yanataka60/ZK80mini_SD/KiCad/KUT_Connector_pretty/README.md

# KUT_Connector.pretty
KUT KiCad Connector footprint library
