yanataka60/ZK80mini_SD/JPEG/ZK80mini_sd_2.JPG

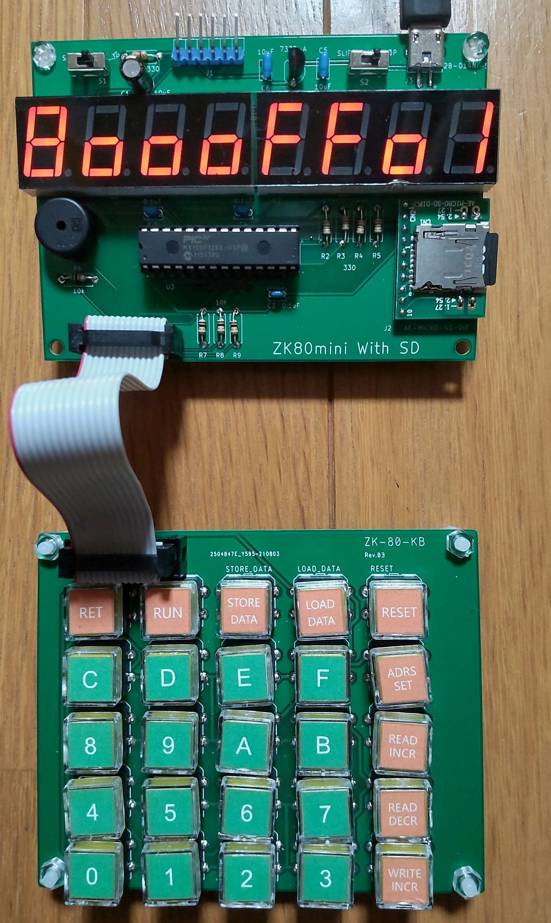
JPEG/ZK80mini_sd_2.JPG
