yanataka60/ZK80mini_SD/KiCad/zk80mini_SD.pdf

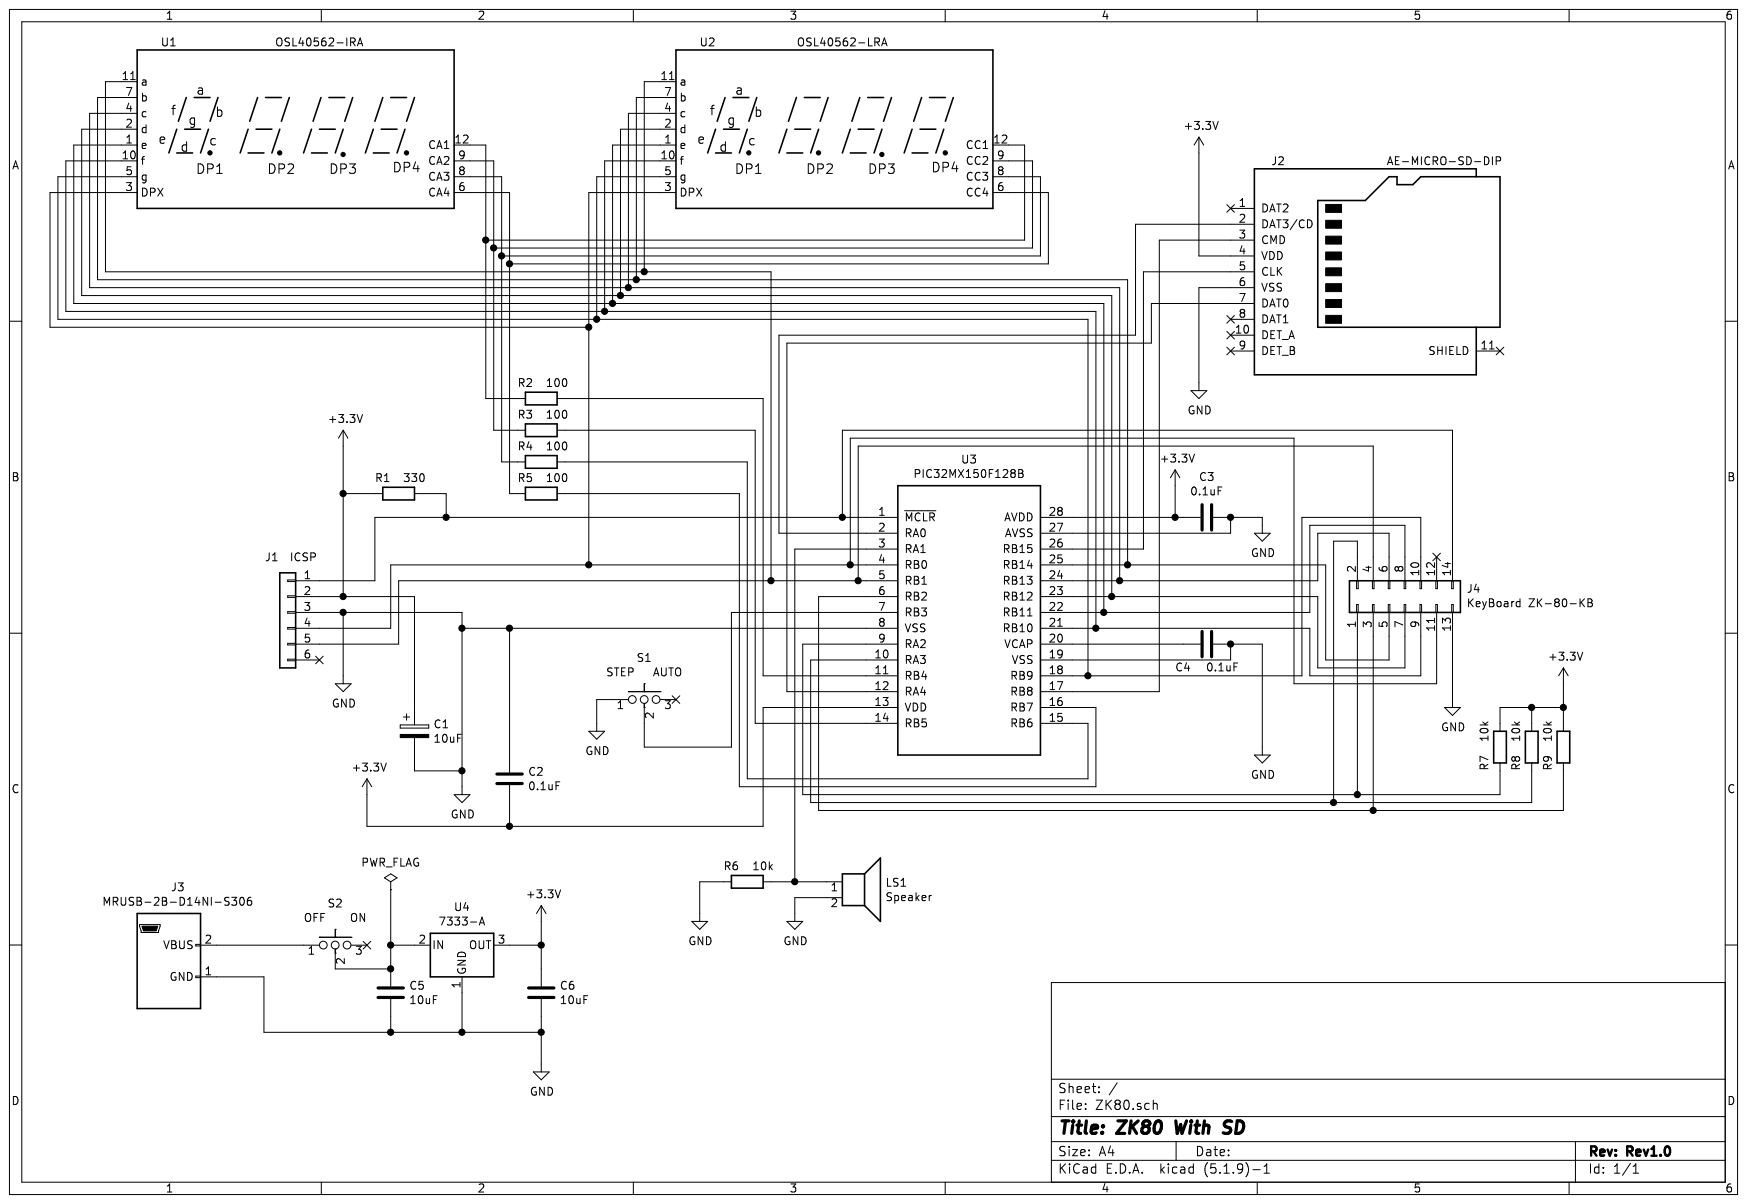
[picture p4: page 1]
