yanataka60/ZK80mini_SD/(list of files, drawings)

Other design files:
KiCad/ZK80.dsn
