yanataka60/ZK80mini_SD/KiCad/ZK80.kicad_pcb

## KiCad design KiCad/ZK80.kicad_pcb (2022-05-04)

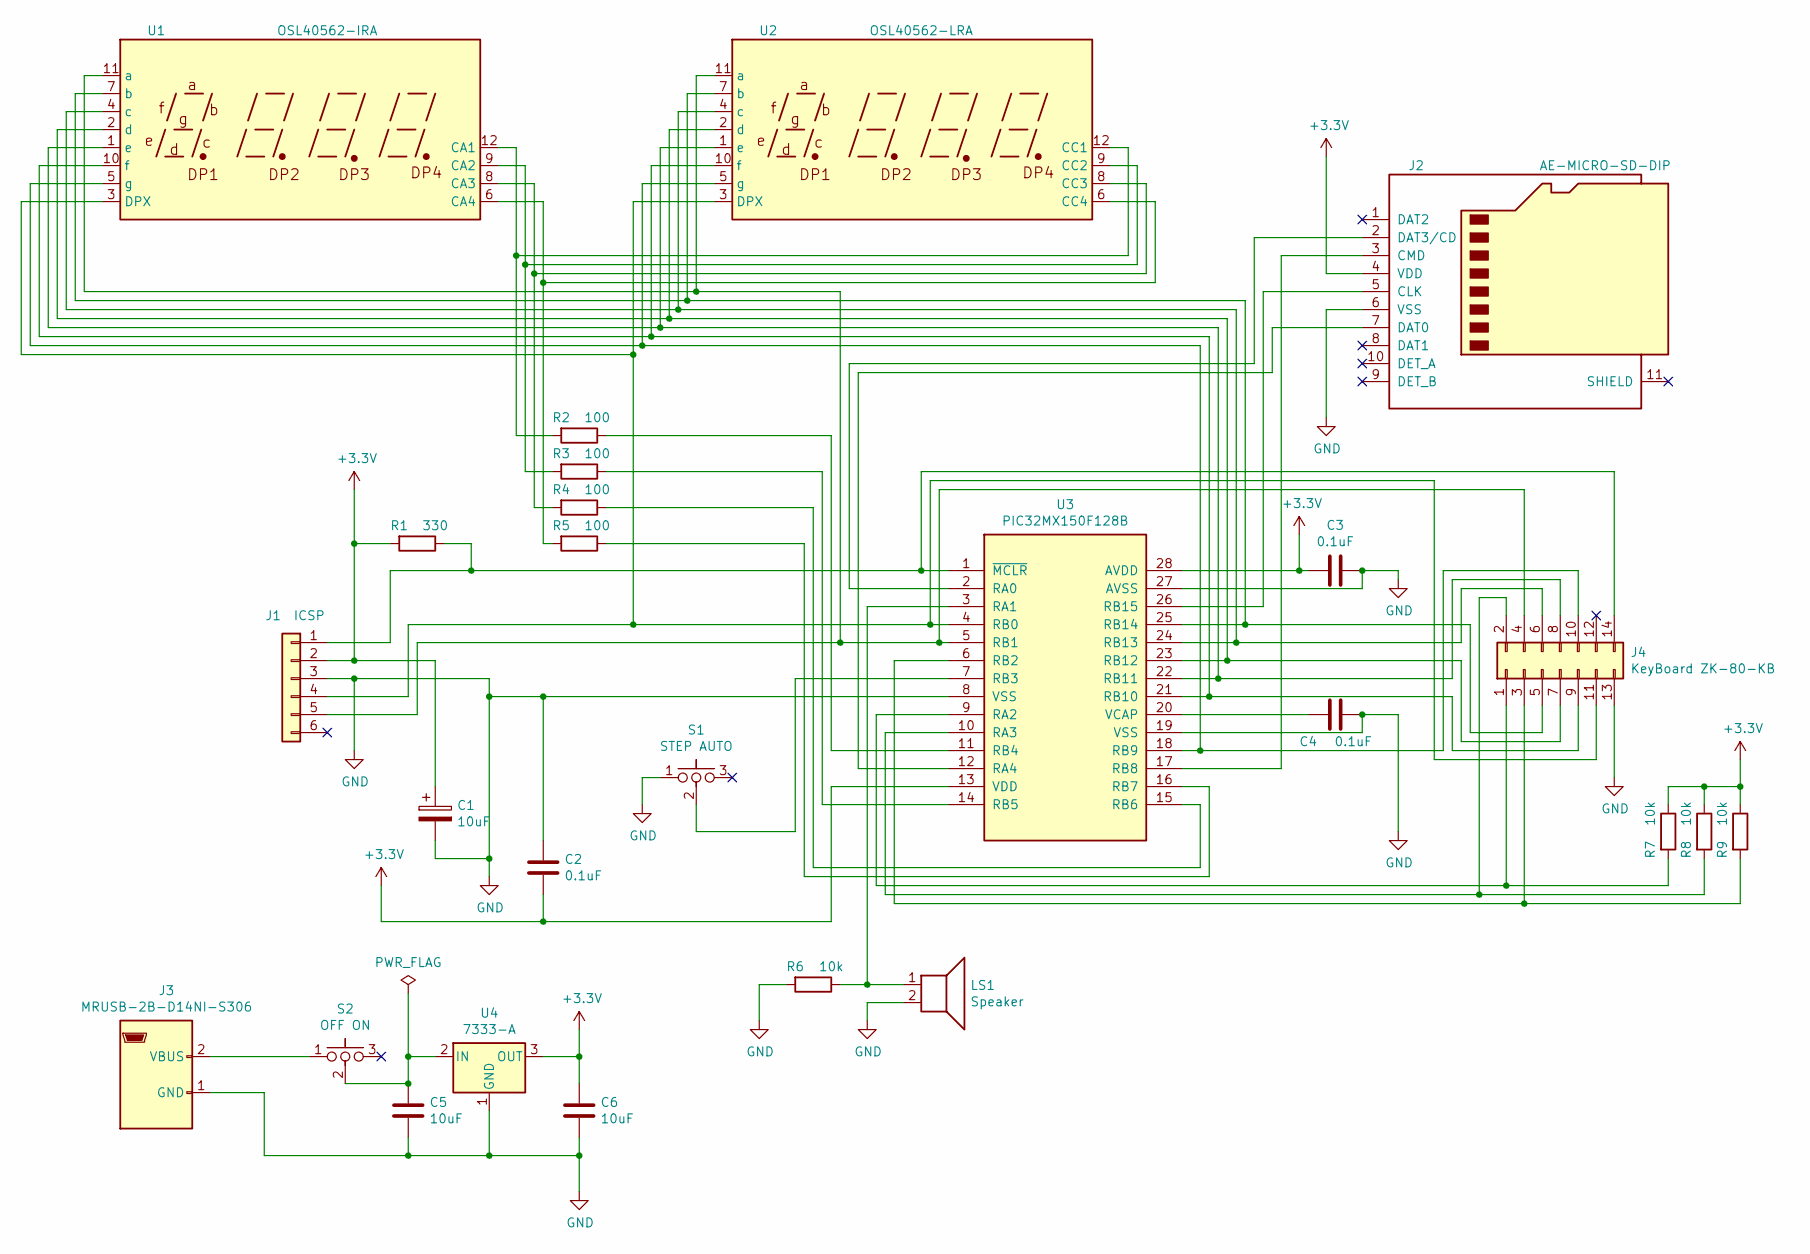
[picture p5: schematic ZK80.sch, ZK80 With SD]

Parts:
C1: 10uF; CP_Radial_D5.0mm_P2.50mm
C2, C3, C4: 0.1uF; C_Rect_L4.0mm_W2.5mm_P2.50mm
C5, C6: 10uF; C_Rect_L4.0mm_W2.5mm_P2.50mm
J1: ICSP; PinHeader_1x06_P2.54mm_Horizontal
J2: AE-MICRO-SD-DIP
J3: MRUSB-2B-D14NI-S306
J4: KeyBoard ZK-80-KB; PinHeader_2x07_P2.54mm_Vertical
LS1: Speaker; TO-5-2
R1: 330; R_Axial_DIN0207_L6.3mm_D2.5mm_P7.62mm_Horizontal
R2, R3, R4, R5: 100; R_Axial_DIN0207_L6.3mm_D2.5mm_P7.62mm_Horizontal
R6, R7, R8, R9: 10k; R_Axial_DIN0207_L6.3mm_D2.5mm_P7.62mm_Horizontal
S1: STEP AUTO; PinHeader_1x03_P2.54mm_Vertical
S2: OFF ON; PinHeader_1x03_P2.54mm_Vertical
U1: OSL40562-IRA; CA56-12EWA
U2: OSL40562-LRA; CA56-12EWA
U3: PIC32MX150F128B; DIP-28_W7.62mm_LongPads
U4: 7333-A; TO-92_Inline_Wide

Connections:
+3V3: C1.1, C2.2, C3.1, C6.1, J1.2, J2.4 (VDD), R1.2, R7.1, R8.1, R9.1, U3.13 (VDD), U3.28 (AVDD), U4.3 (OUT)
GND: C1.2, C2.1, C3.2, C4.2, C5.2, C6.2, J1.3, J2.6 (VSS), J3.1 (GND), J4.13, LS1.2, R6.2, S1.1, U3.8 (VSS), U3.19 (VSS), U3.27 (AVSS), U4.1 (GND)
unnamed: C4.1, U3.20 (VCAP)
unnamed: C5.1, S2.2, U4.2 (IN)
unnamed: J1.1, J4.14, R1.1, U3.1 (~MCLR)
unnamed: J1.4, J4.11, U1.3 (DPX), U2.3 (DPX), U3.4 (RB0)
unnamed: J1.5, J4.4, U1.11 (a), U2.11 (a), U3.5 (RB1)
unnamed: J2.2 (DAT3/CD), U3.2 (RA0)
unnamed: J2.3 (CMD), U3.17 (RB8)
unnamed: J2.5 (CLK), U3.26 (RB15)
unnamed: J2.7 (DAT0), U3.12 (RA4)
unnamed: J3.2 (VBUS), S2.1
unnamed: J4.1, R7.2, U3.9 (RA2)
unnamed: J4.2, R8.2, U3.10 (RA3)
unnamed: J4.3, R9.2, U3.6 (RB2)
unnamed: J4.5, U1.7 (b), U2.7 (b), U3.25 (RB14)
unnamed: J4.6, U1.4 (c), U2.4 (c), U3.24 (RB13)
unnamed: J4.7, U1.2 (d), U2.2 (d), U3.23 (RB12)
unnamed: J4.8, U1.1 (e), U2.1 (e), U3.22 (RB11)
unnamed: J4.9, U1.10 (f), U2.10 (f), U3.21 (RB10)
unnamed: J4.10, U1.5 (g), U2.5 (g), U3.18 (RB9)
unnamed: LS1.1, R6.1, U3.3 (RA1)
unnamed: R2.1, U3.11 (RB4)
unnamed: R2.2, U1.12 (CA1), U2.12 (CC1)
unnamed: R3.1, U3.14 (RB5)
unnamed: R3.2, U1.9 (CA2), U2.9 (CC2)
unnamed: R4.1, U3.15 (RB6)
unnamed: R4.2, U1.8 (CA3), U2.8 (CC3)
unnamed: R5.1, U3.16 (RB7)
unnamed: R5.2, U1.6 (CA4), U2.6 (CC4)
unnamed: S1.2, U3.7 (RB3)

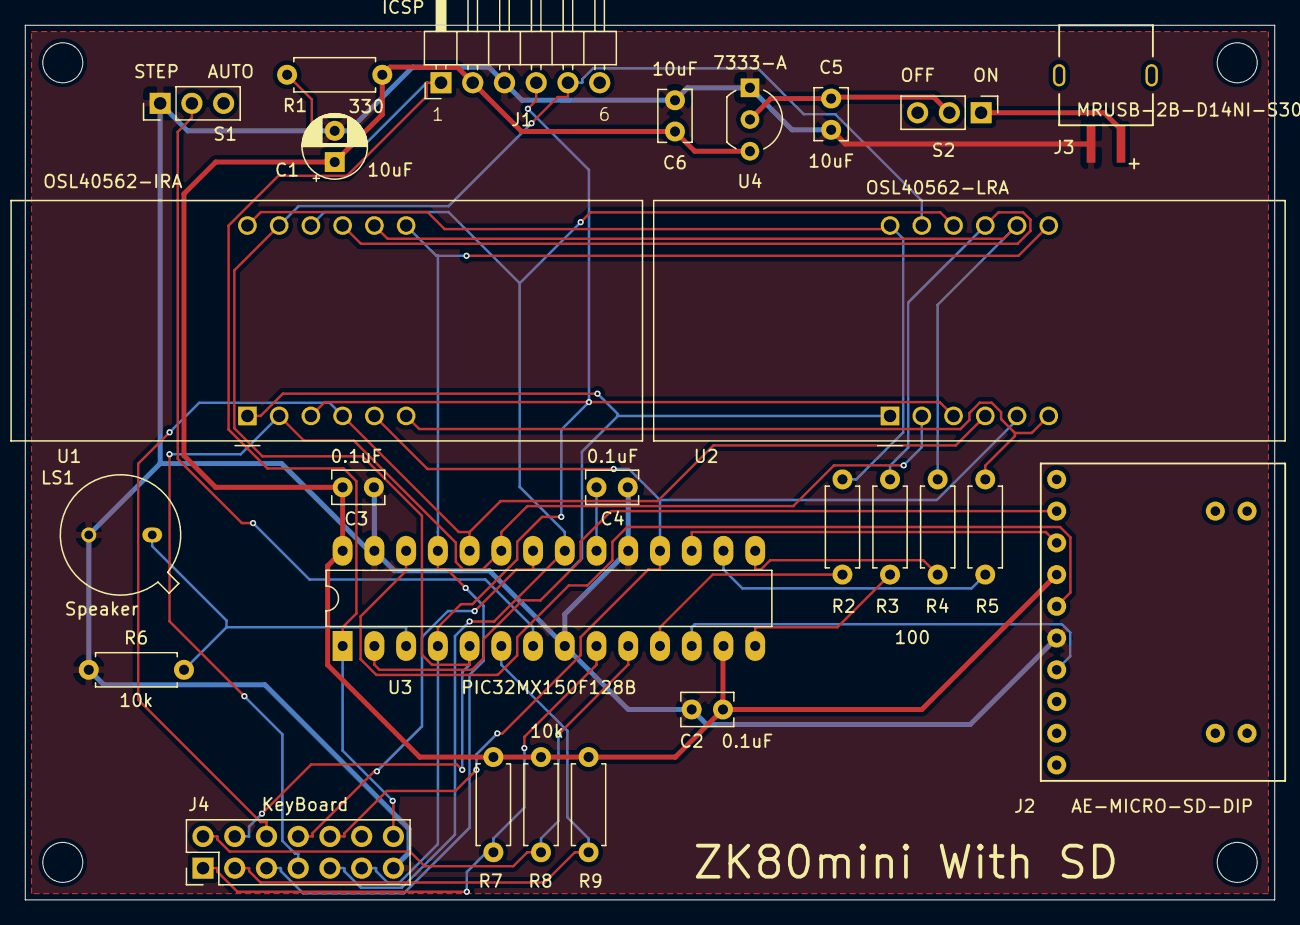
[picture p6: board ZK80.kicad_pcb from above]

Board: 2 copper layers, 100.0 x 70.0 mm, 30 parts (0 on the bottom side), 31 nets.

Other parts of the board:
MH1, MH2, MH3, MH4: MountingHole_3.2mm_M3
