yanataka60/ZK80mini_SD/MPLAB/zk80mini_SD/z80jump.h

/*
   This program is provided under the LGPL license ver 2.
   Written by Katsumi.
   http://hp.vector.co.jp/authors/VA016157/
   kmorimatsu@users.sourceforge.jp
*/

void execZ80infinite(){
	UINT8 code;
	while(1) {
		code=_getCode();
		execZ80(code);
	}
}
void execZ80code(){
	UINT8 code;
	code=_getCode();
	execZ80(code);
	if (z80irq) doZ80Int();
}
void execZ80(UINT8 code){
	if (!(code&0x80)) {
		if (!(code&0x40)) {
			if (!(code&0x20)) {
				if (!(code&0x10)) {
					if (!(code&0x8)) {
						if (!(code&0x4)) {
							if (!(code&0x2)) {
								if (!(code&0x1)) {
									code00();
								} else {
									code01();
								}
							} else {
								if (!(code&0x1)) {
									code02();
								} else {
									code03();
								}
							}
						} else {
							if (!(code&0x2)) {
								if (!(code&0x1)) {
									code04();
								} else {
									code05();
								}
							} else {
								if (!(code&0x1)) {
									code06();
								} else {
									code07();
								}
							}
						}
					} else {
						if (!(code&0x4)) {
							if (!(code&0x2)) {
								if (!(code&0x1)) {
									#ifdef Z80
										code08();
									#endif
									#ifdef I8080
										codeVOID();
									#endif
								} else {
									code09();
								}
							} else {
								if (!(code&0x1)) {
									code0A();
								} else {
									code0B();
								}
							}
						} else {
							if (!(code&0x2)) {
								if (!(code&0x1)) {
									code0C();
								} else {
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
					} else {
						if (!(code&0x4)) {
							codeVOID();
						} else {
							if (!(code&0x2)) {
								codeVOID();
							} else {
								if (!(code&0x1)) {
									codeFDCBFE(i16);
								} else {
									codeVOID();
								}
							}
						}
					}
				}
			}
		}
	}
}
#endif //Z80
